ElectroIoT/Restaurant-Calling-Bell/docs/datasheets/module-photo-front.jpg

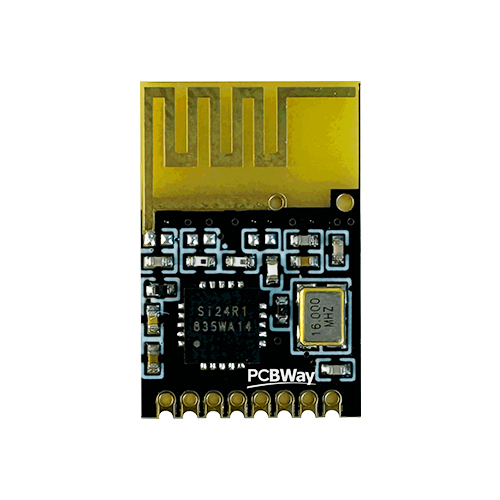
docs/datasheets/module-photo-front.jpg
