ElectroIoT/Restaurant-Calling-Bell/docs/datasheets/module-photo-back.jpg

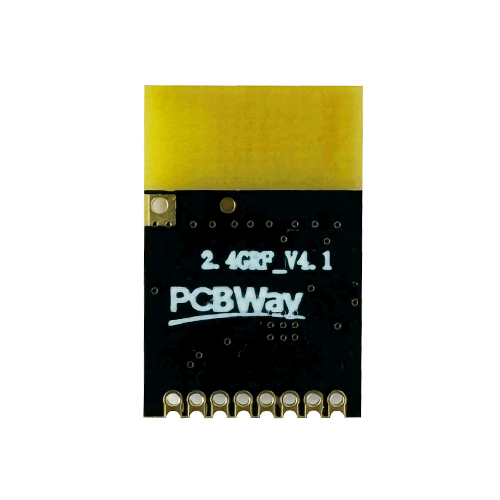
docs/datasheets/module-photo-back.jpg
