ElectroIoT/Restaurant-Calling-Bell/hardware/receiver/kicad/pcb-3d-bottom.png

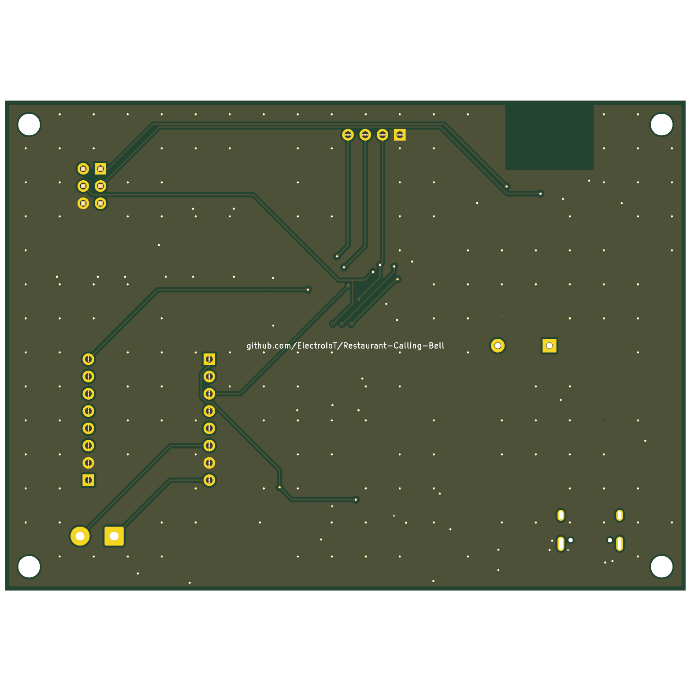
hardware/receiver/kicad/pcb-3d-bottom.png
