ElectroIoT/Restaurant-Calling-Bell/hardware/receiver/kicad/pcb-3d-top.png

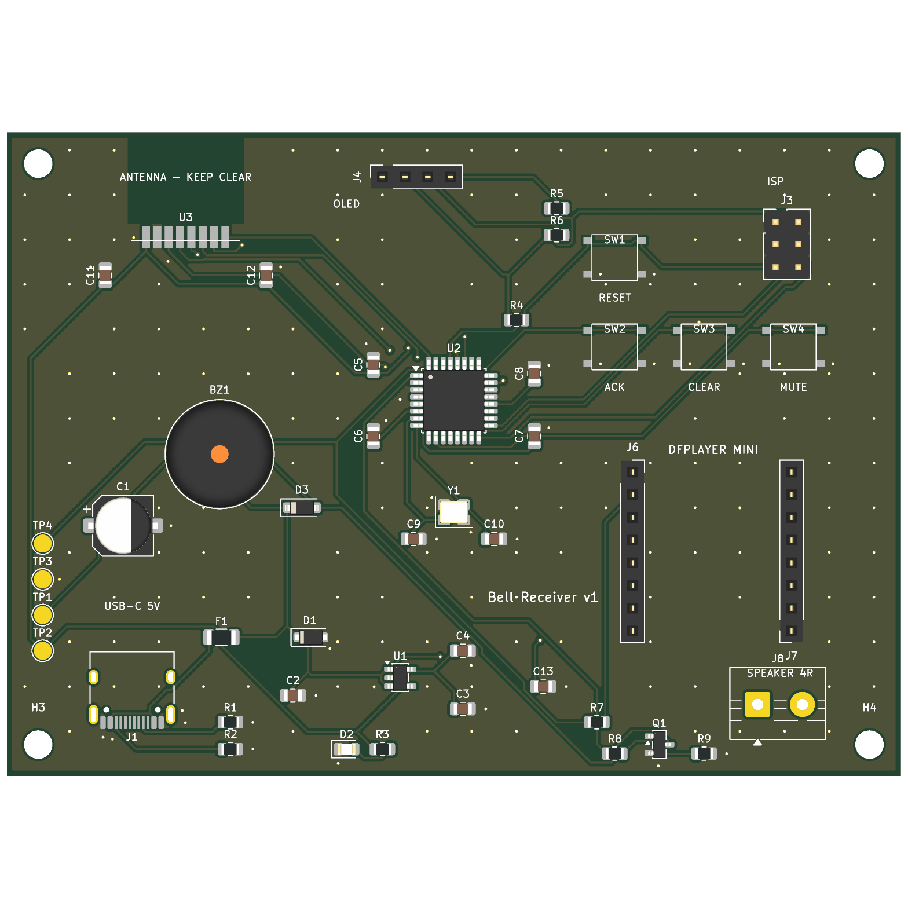
hardware/receiver/kicad/pcb-3d-top.png
