ElectroIoT/Restaurant-Calling-Bell/hardware/remote/kicad/pcb-3d-bottom.png

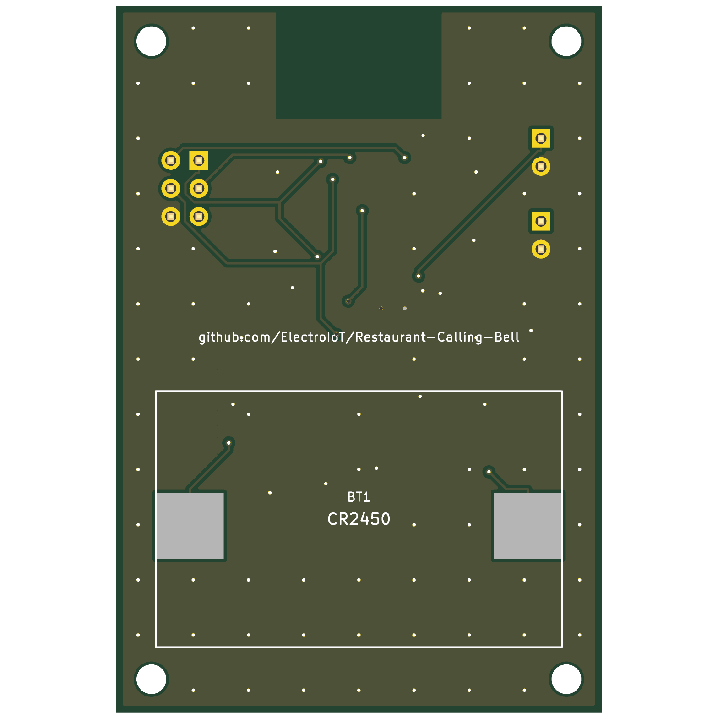
hardware/remote/kicad/pcb-3d-bottom.png
