ElectroIoT/Restaurant-Calling-Bell/hardware/remote/kicad/pcb-3d-top.png

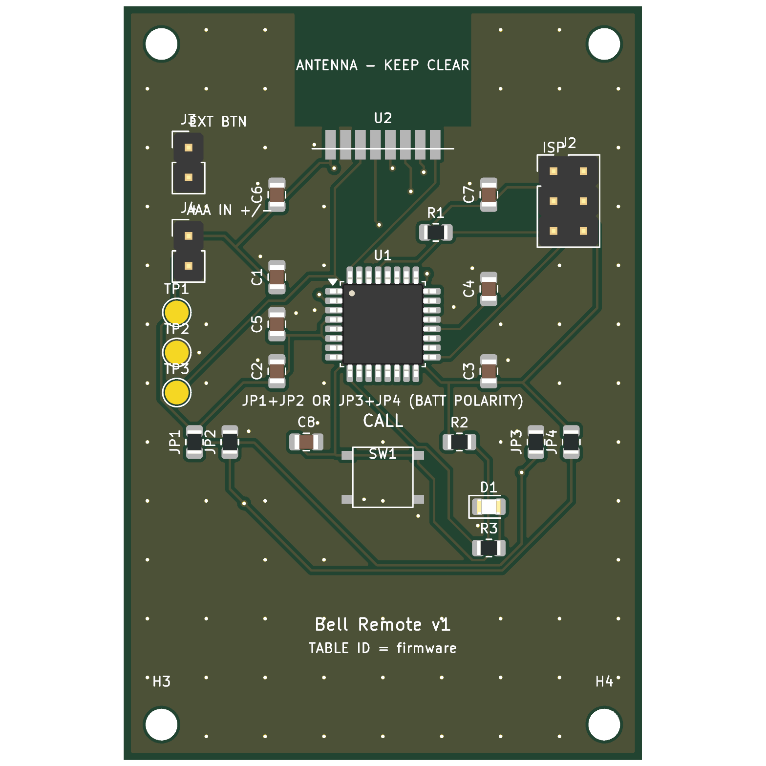
hardware/remote/kicad/pcb-3d-top.png
