ElectroIoT/Restaurant-Calling-Bell/tests/test-results-template.csv

Test # | Test name | Date | Tester | Board set / serial | Firmware git commit | Conditions (battery | distance | channel) | Measured value | Pass criterion | Pass/Fail | Notes
0 | Host protocol tests + firmware builds | 2026-10-29 | Claude (software only) | n/a | see git log | PC | 476 checks 0 failures; 22 builds OK | 0 failures | PASS | Not a hardware result
1 | MCU programming and clock |  |  |  |  |  |  | remote 4 MHz / receiver 8 MHz within 1 %
2 | SPI link |  |  |  |  |  |  | register read-back equals write on all boards
3 | SI24R1 initialisation |  |  |  |  |  |  | RF_SETUP/SETUP_RETR as configured; no RF FAIL
4 | One-way packet |  |  |  |  |  |  | 100/100 at 2 m
5 | Application acknowledgement |  |  |  |  |  |  | solid LED only with receiver up; failure shown <2.5 s
6 | Table id identification |  |  |  |  |  |  | 10/10 correct on OLED and voice
7 | Ten-remote test |  |  |  |  |  |  | 10/10 accepted x10 rounds
8 | Duplicate suppression |  |  |  |  |  |  | one entry per press
9 | Simultaneous calls / collisions |  |  |  |  |  |  | all accepted within 3 s x20
10 | Receiver audio + OLED |  |  |  |  |  |  | reception continues during playback
11 | Debounce / stuck button |  |  |  |  |  |  | one call per press; stuck <10 uA
12 | Battery sag during TX |  |  |  |  |  |  | min voltage >2.2 V; no brown-out
13 | Sleep current |  |  |  |  |  |  | <=5 uA (assumed)
14 | Indoor range |  |  |  |  |  |  | >=19/20 per table
15 | Wi-Fi interference |  |  |  |  |  |  | >=95 % first attempt
16 | Receiver restart / queue recovery |  |  |  |  |  |  | same tables and order restored
17 | 72 h soak |  |  |  |  |  |  | no lost call / reset
18 | Low-battery behaviour |  |  |  |  |  |  | flag from 2.4 V; record cut-off
19 | Regression after firmware change |  |  |  |  |  |  | tests 4-9 and 16 pass
20 | Amplifier thermal |  |  |  |  |  |  | finger-safe; droop <0.3 V
