ElectroIoT/Restaurant-Calling-Bell/hardware/receiver/kicad/BellReceiver-schematic.pdf

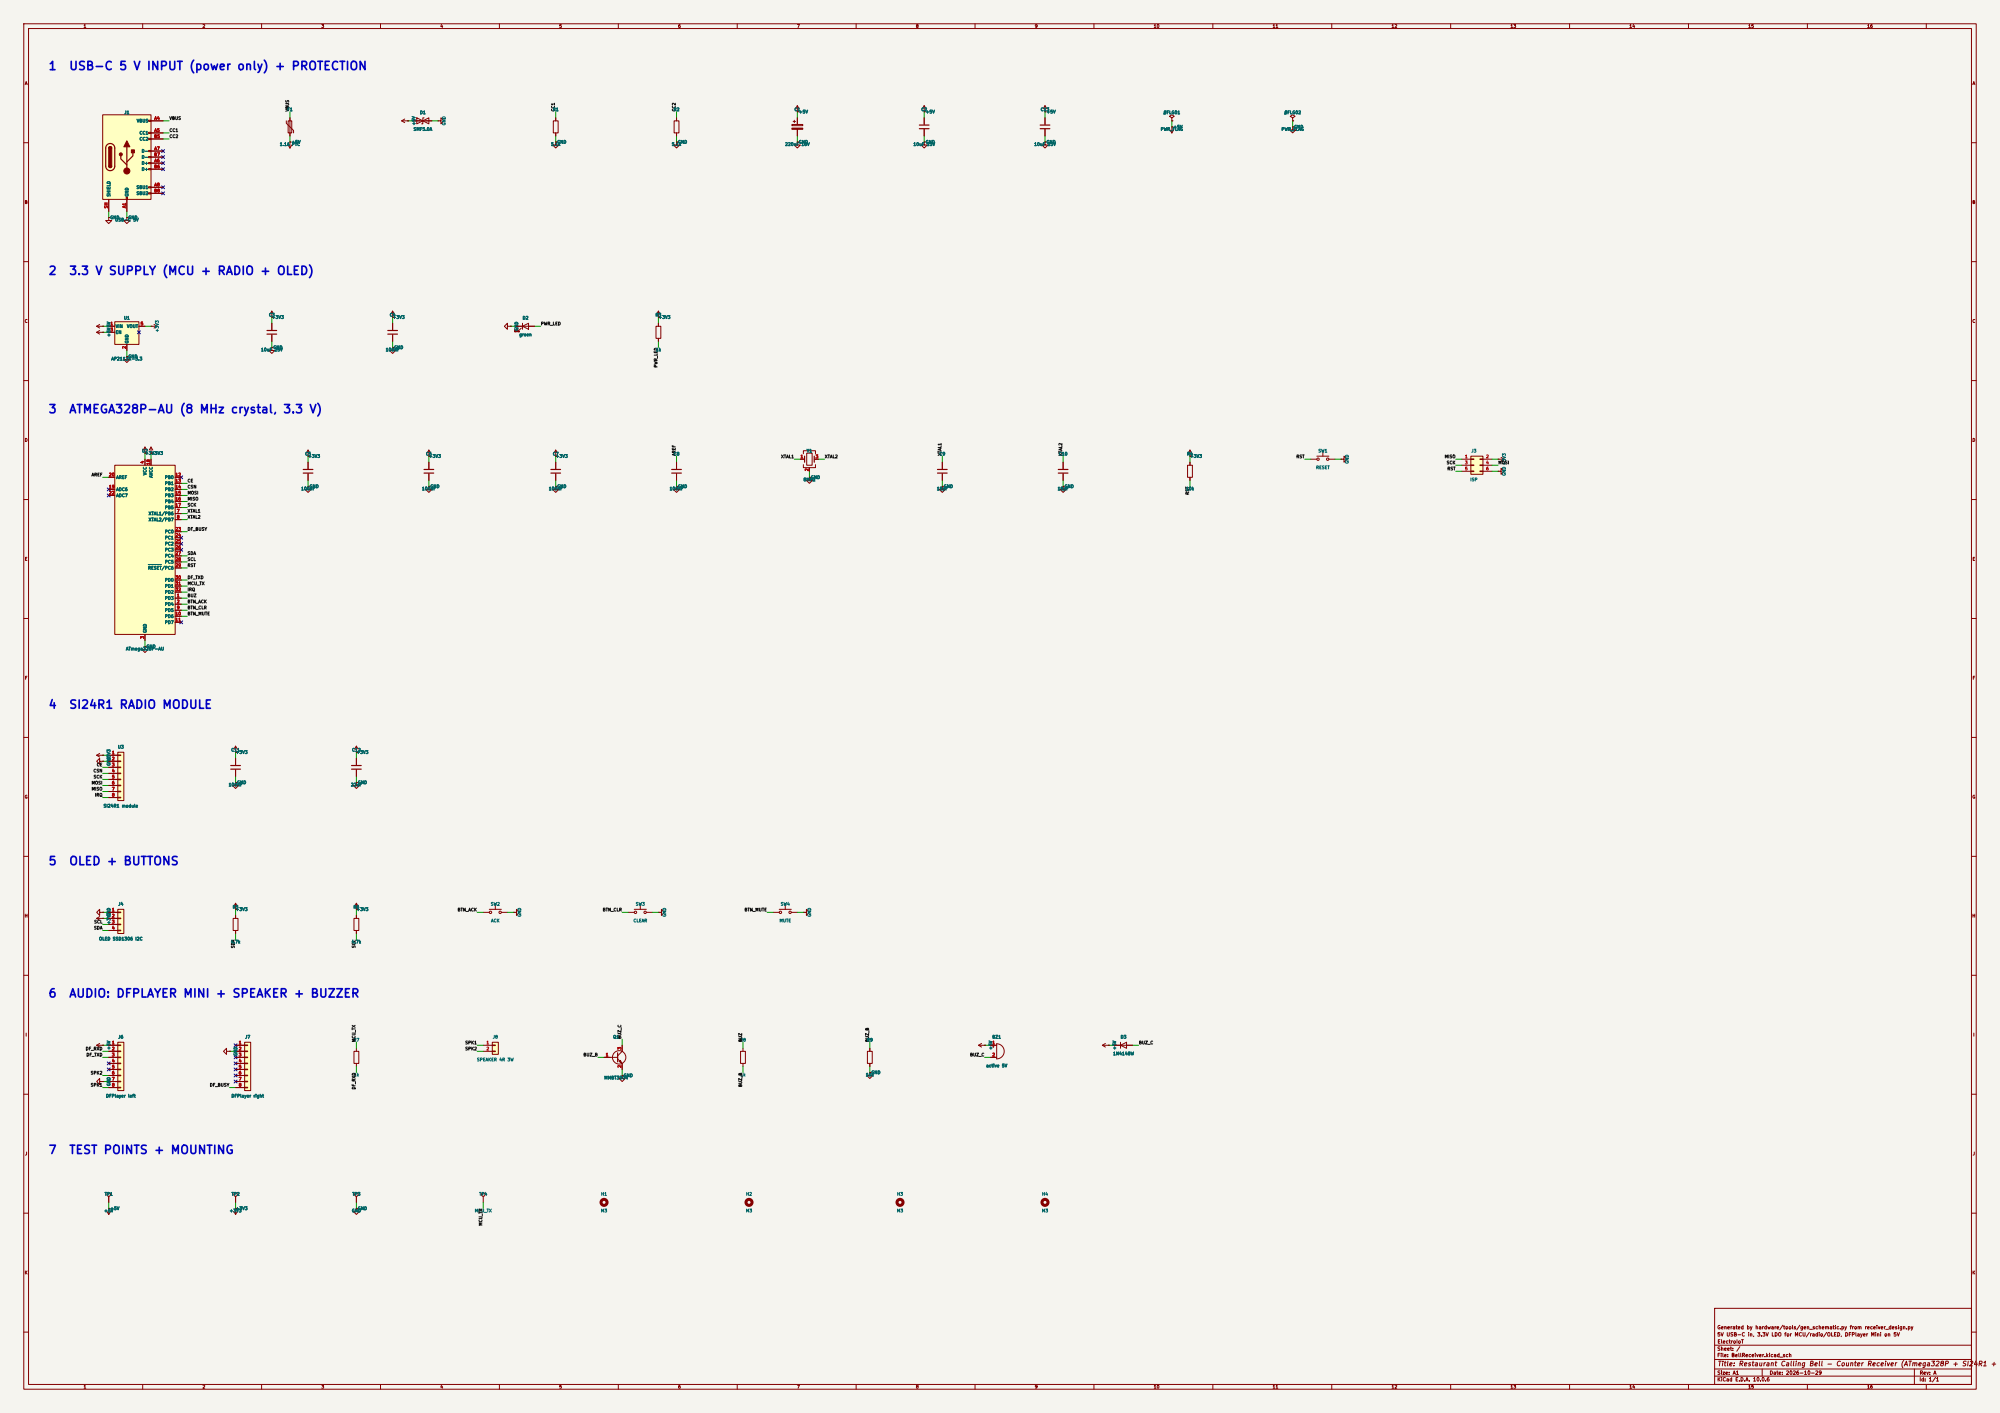
[picture p7: page 1]

1 USB-C 5 V INPUT (power only) + PROTECTION

CE SDA SCL SCK MISO 2 3.3 V SUPPLY (MCU + RADIO + OLED)

Generated by hardware/tools/gen_schematic.py from receiver_design.py
5V USB-C in, 3.3V LDO for MCU/radio/OLED, DFPlayer Mini on 5V
ElectroIoT
Sheet: /
File: BellReceiver.kicad_sch
Title: Restaurant Calling Bell - Counter Receiver (ATmega328P + SI24R1 + OLED + DFPlayer)

Size: A1 | Rev: A
KiCad E.D.A. 10.0.6 | Id: 1/1
