ElectroIoT/Restaurant-Calling-Bell/hardware/remote/kicad/BellRemote-schematic.pdf

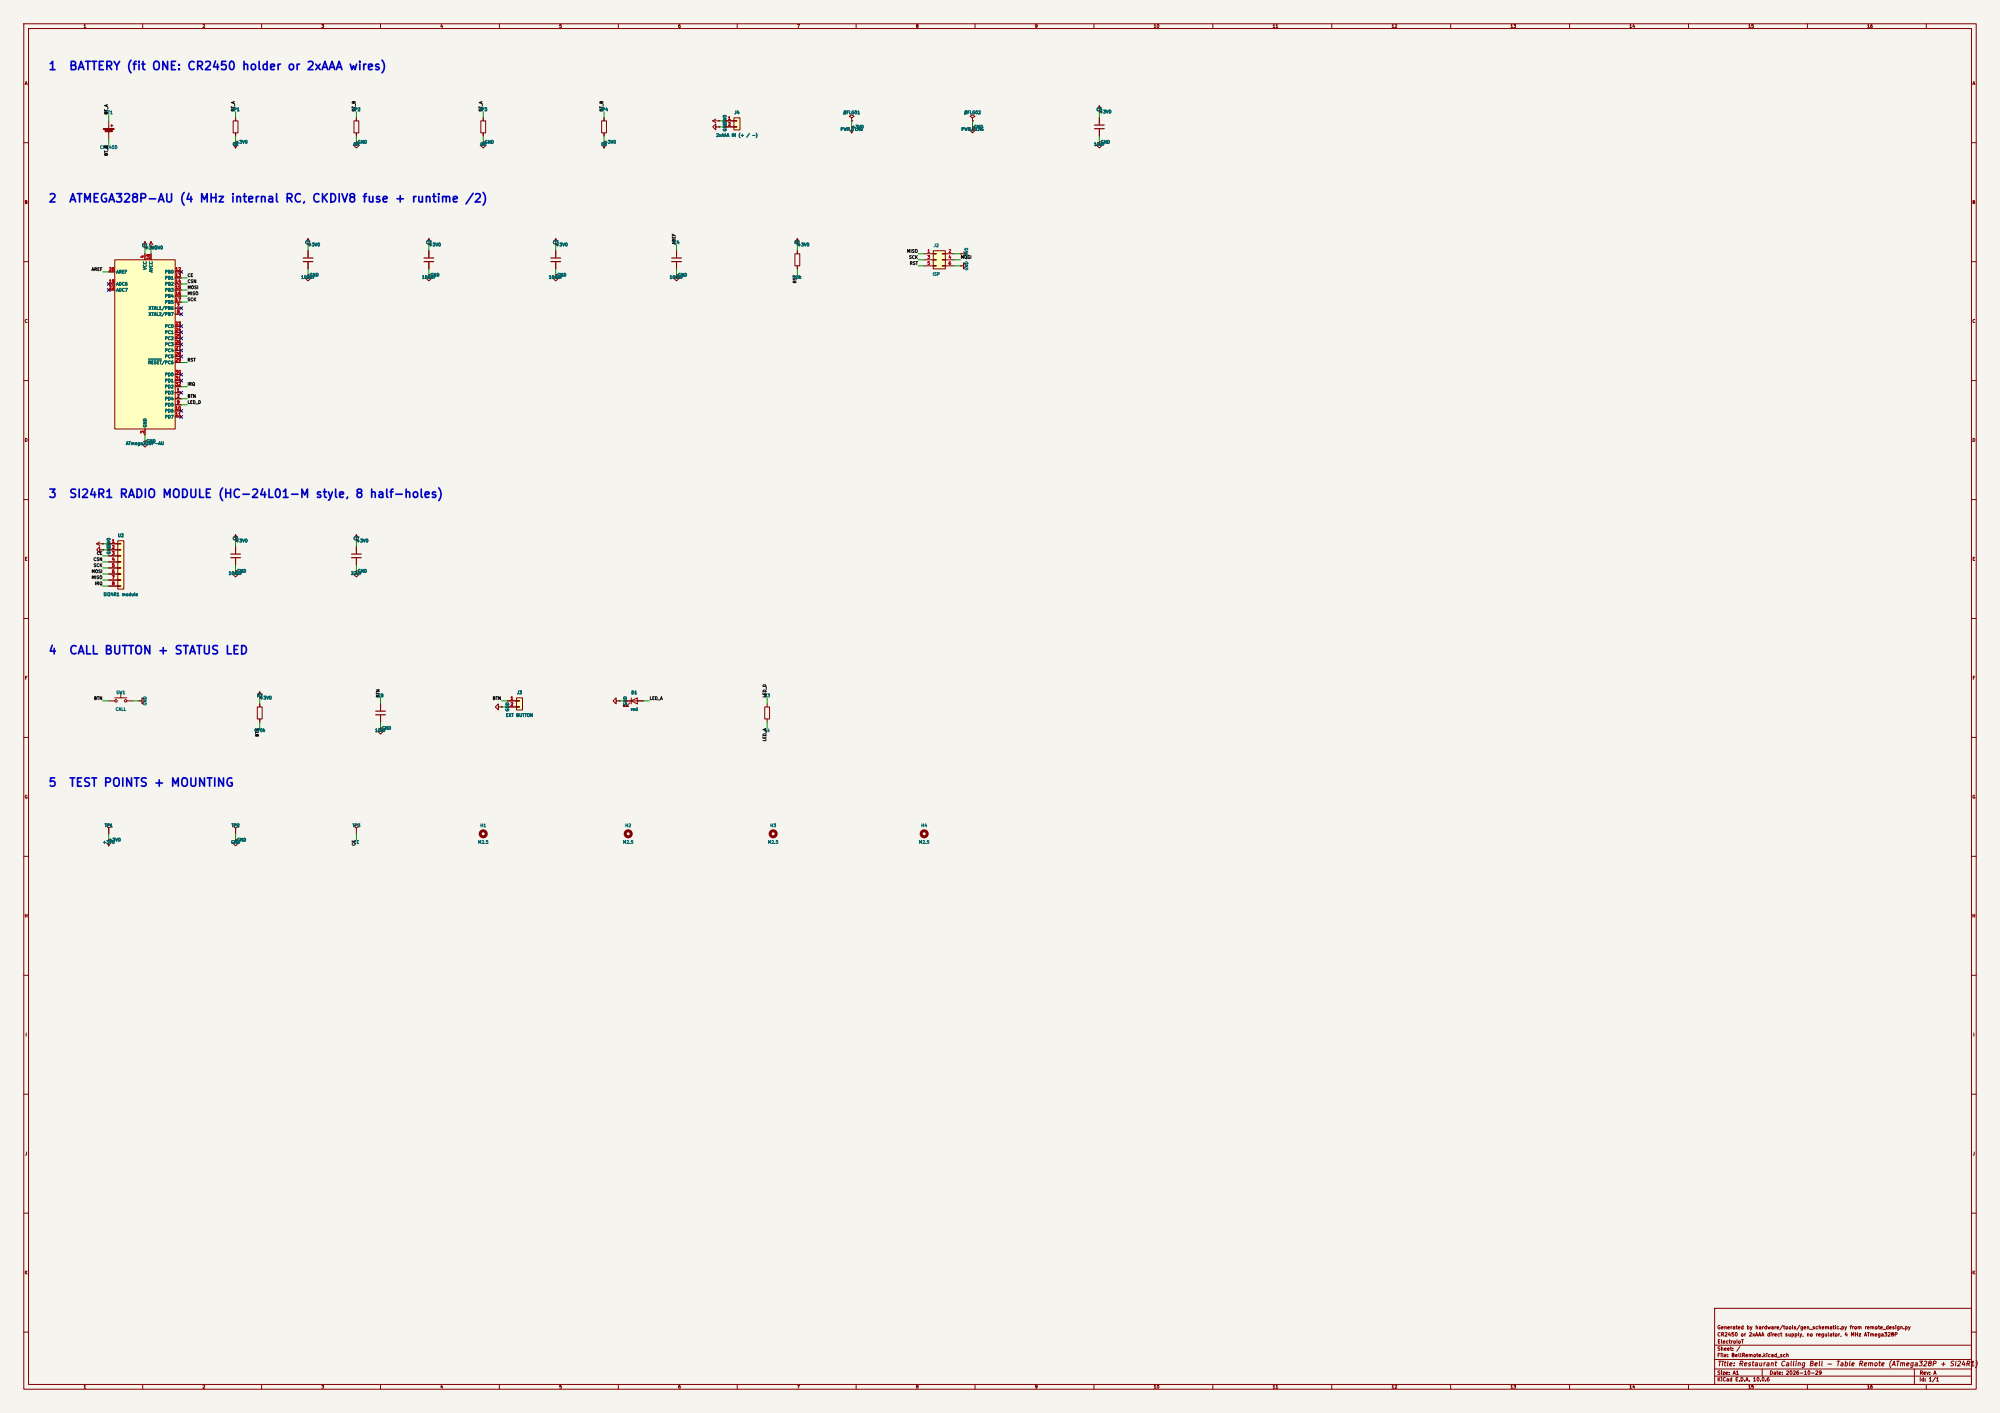
[picture p8: page 1]

CE CSN 1 BATTERY (fit ONE: CR2450 holder or 2xAAA wires)

2 ATMEGA328P-AU (4 MHz internal RC, CKDIV8 fuse + runtime /2)

3 SI24R1 RADIO MODULE (HC-24L01-M style, 8 half-holes)

4 CALL BUTTON + STATUS LED

Generated by hardware/tools/gen_schematic.py from remote_design.py
CR2450 or 2xAAA direct supply, no regulator, 4 MHz ATmega328P
ElectroIoT
Sheet: /
File: BellRemote.kicad_sch
Title: Restaurant Calling Bell - Table Remote (ATmega328P + SI24R1)

Size: A1 | Rev: A
KiCad E.D.A. 10.0.6 | Id: 1/1
