ElectroIoT/Restaurant-Calling-Bell/hardware/receiver/kicad/BellReceiver.kicad_pcb

## KiCad design hardware/receiver/kicad/BellReceiver.kicad_pcb (2026-10-29)

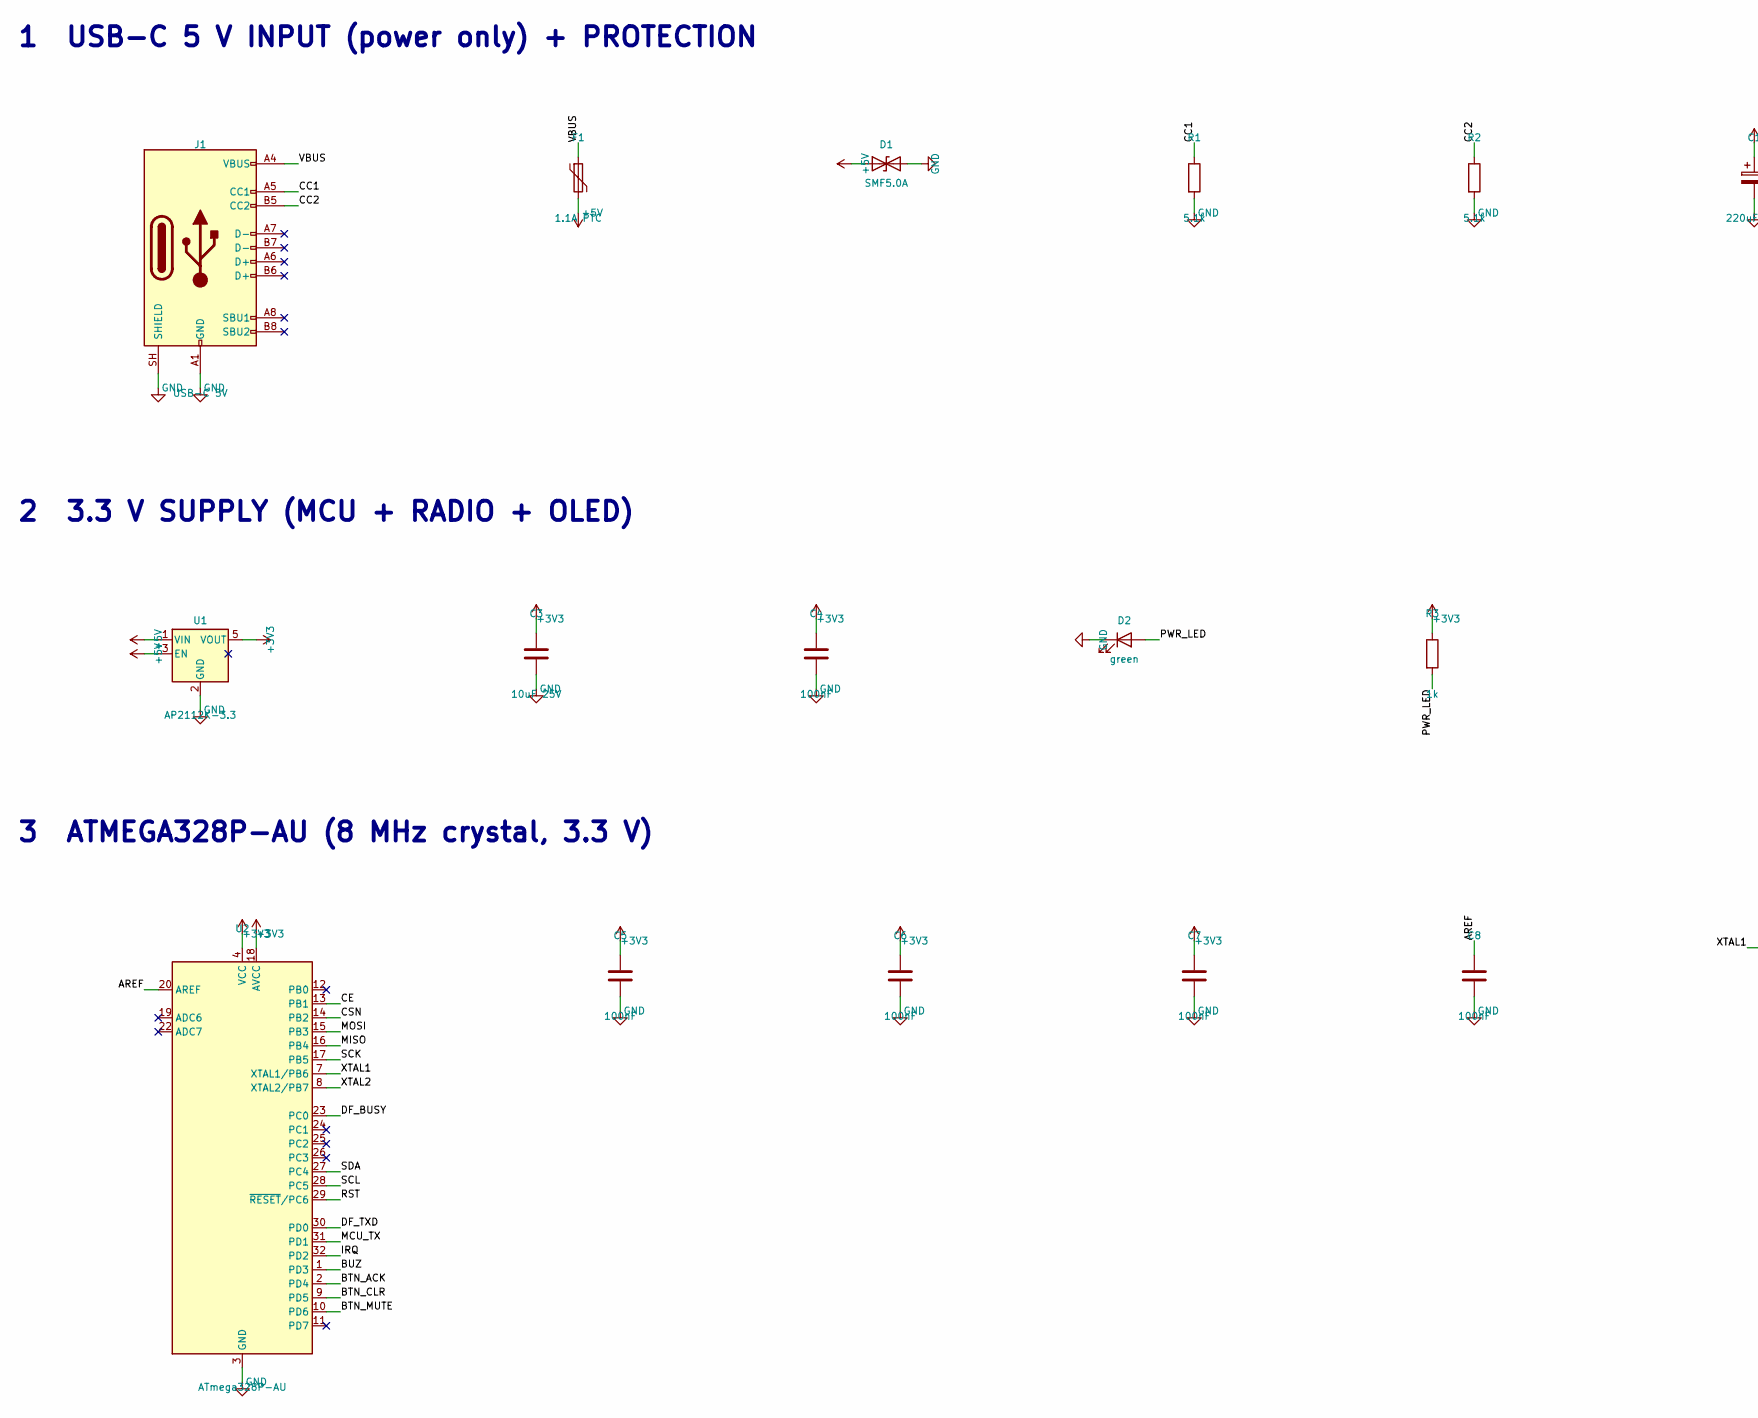
[picture p9: schematic BellReceiver.kicad_sch, Restaurant Calling Bell - Counter Receiver (ATmega328P + SI…, part in row 1, column 1]

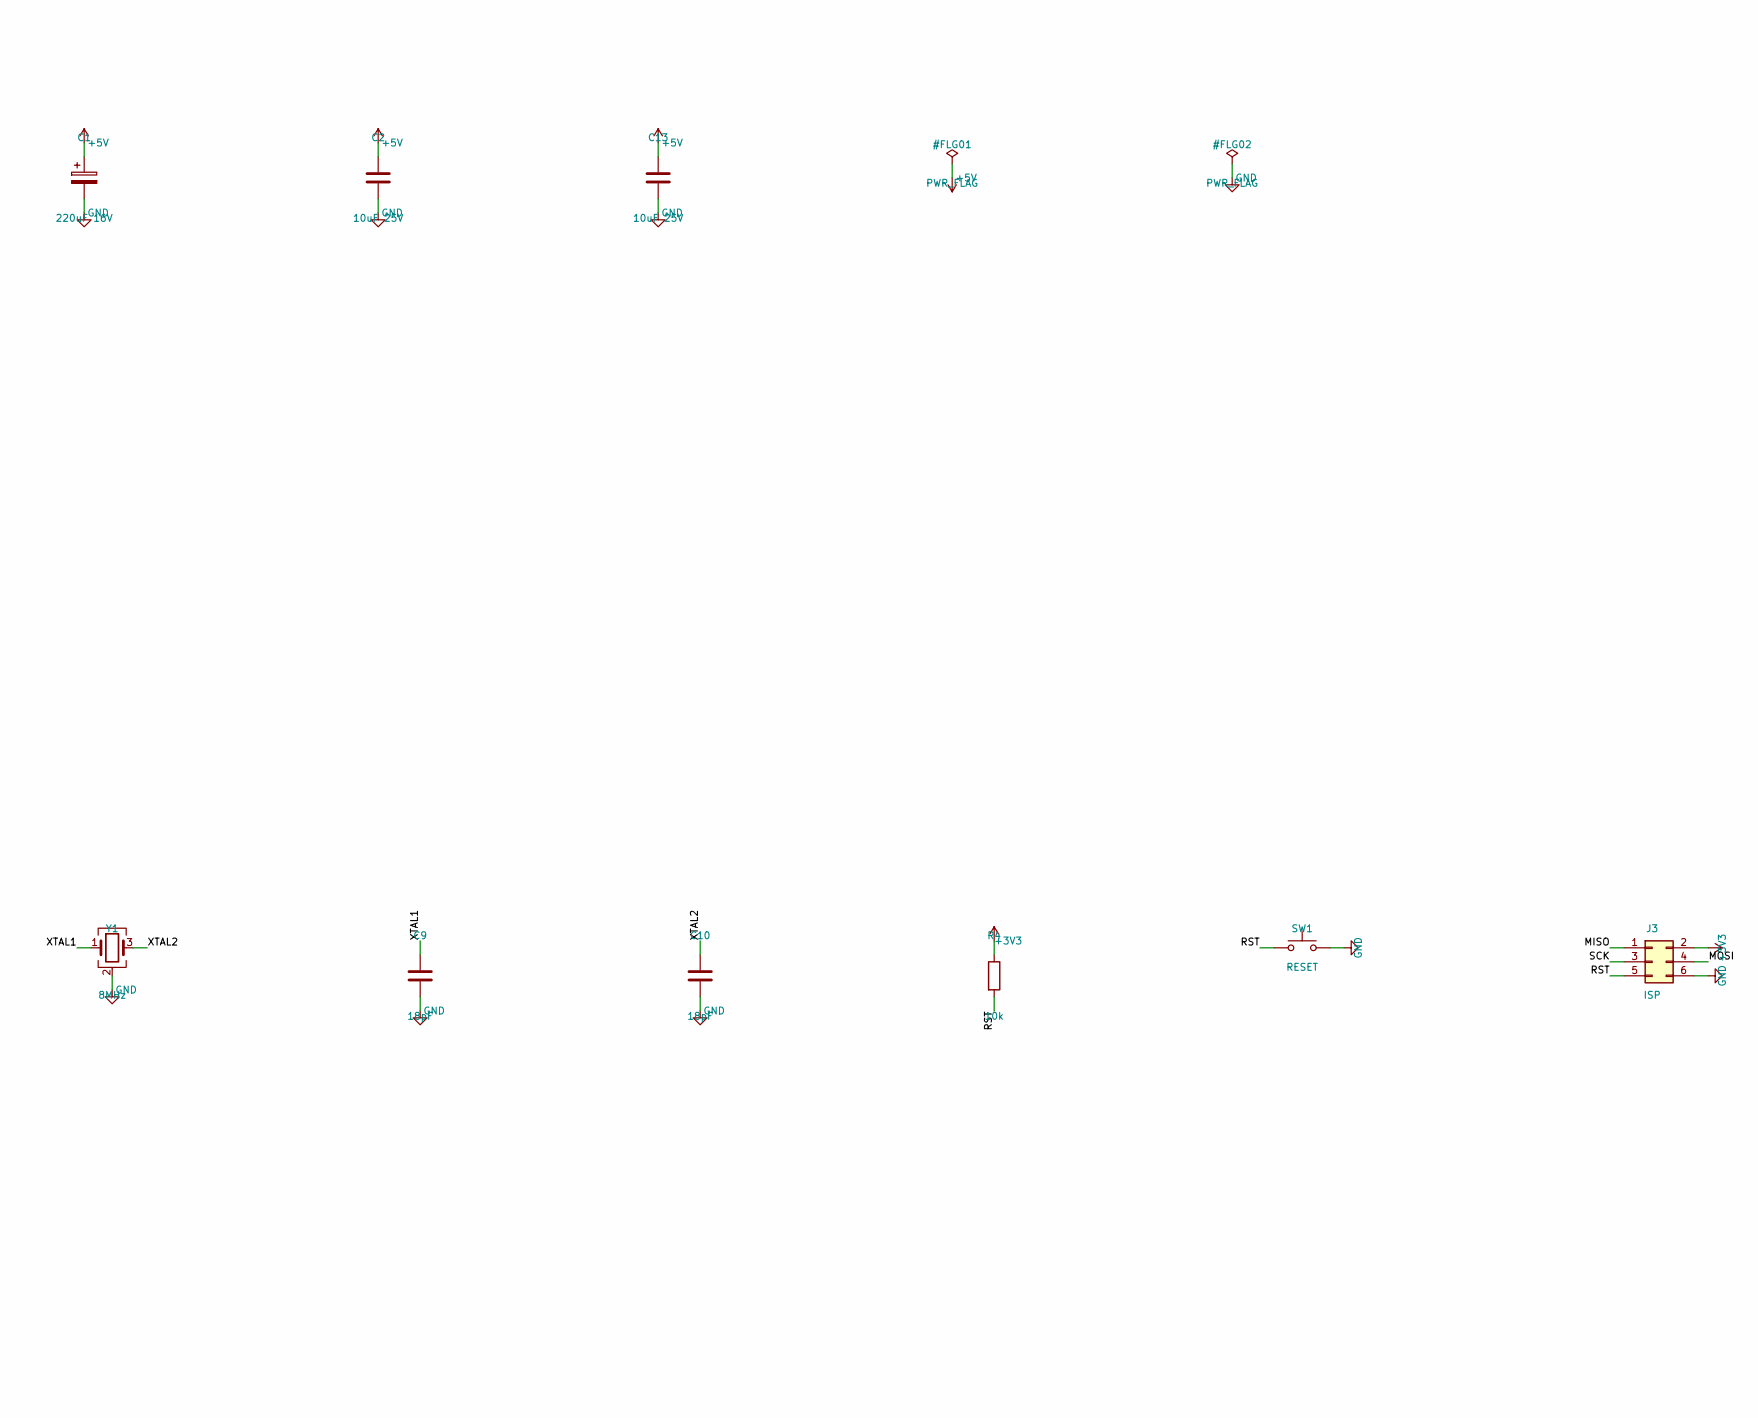
[picture p10: schematic BellReceiver.kicad_sch, Restaurant Calling Bell - Counter Receiver (ATmega328P + SI…, part in row 1, column 2]

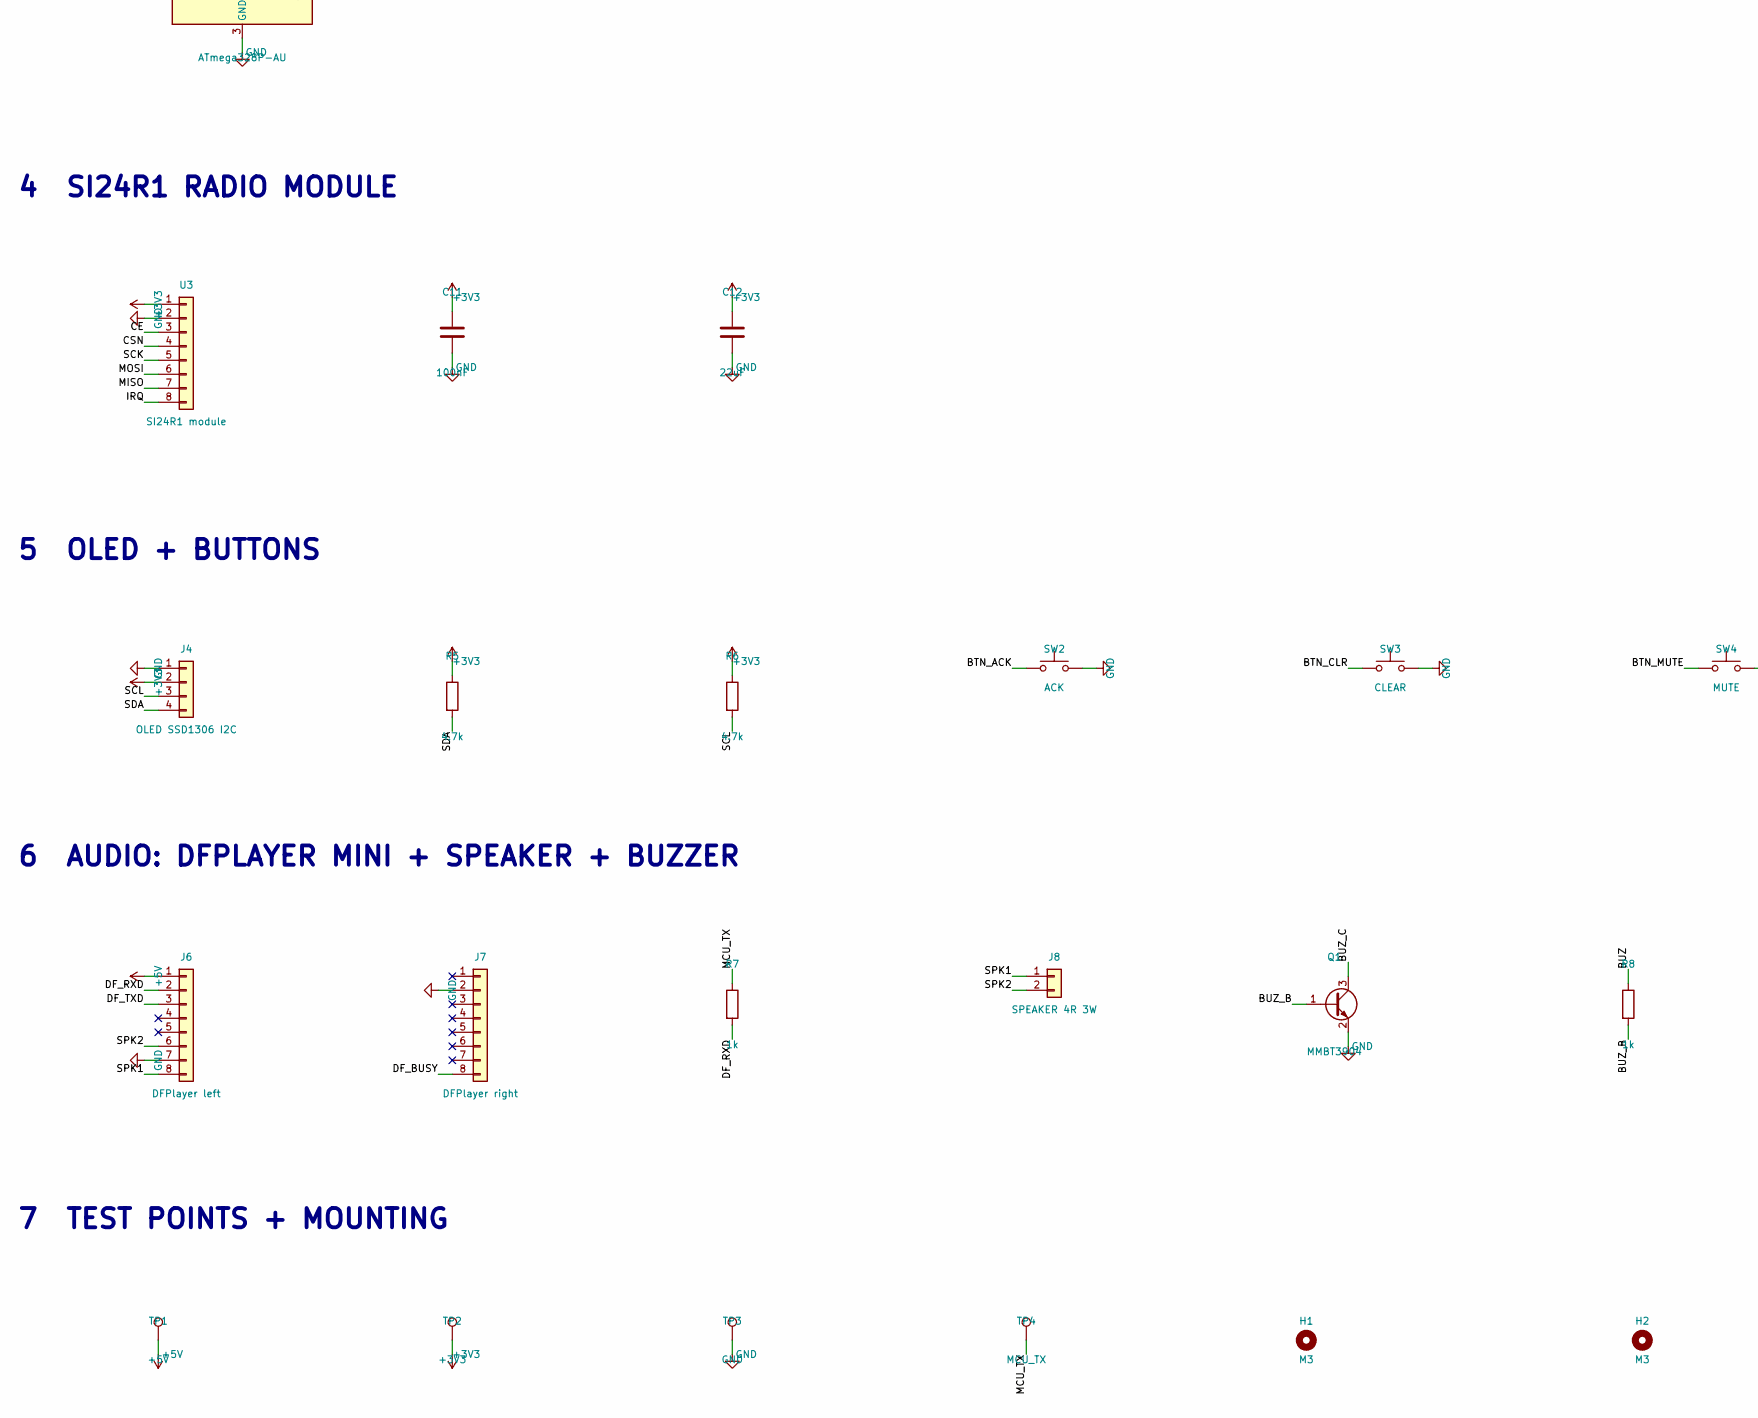
[picture p11: schematic BellReceiver.kicad_sch, Restaurant Calling Bell - Counter Receiver (ATmega328P + SI…, part in row 2, column 1]

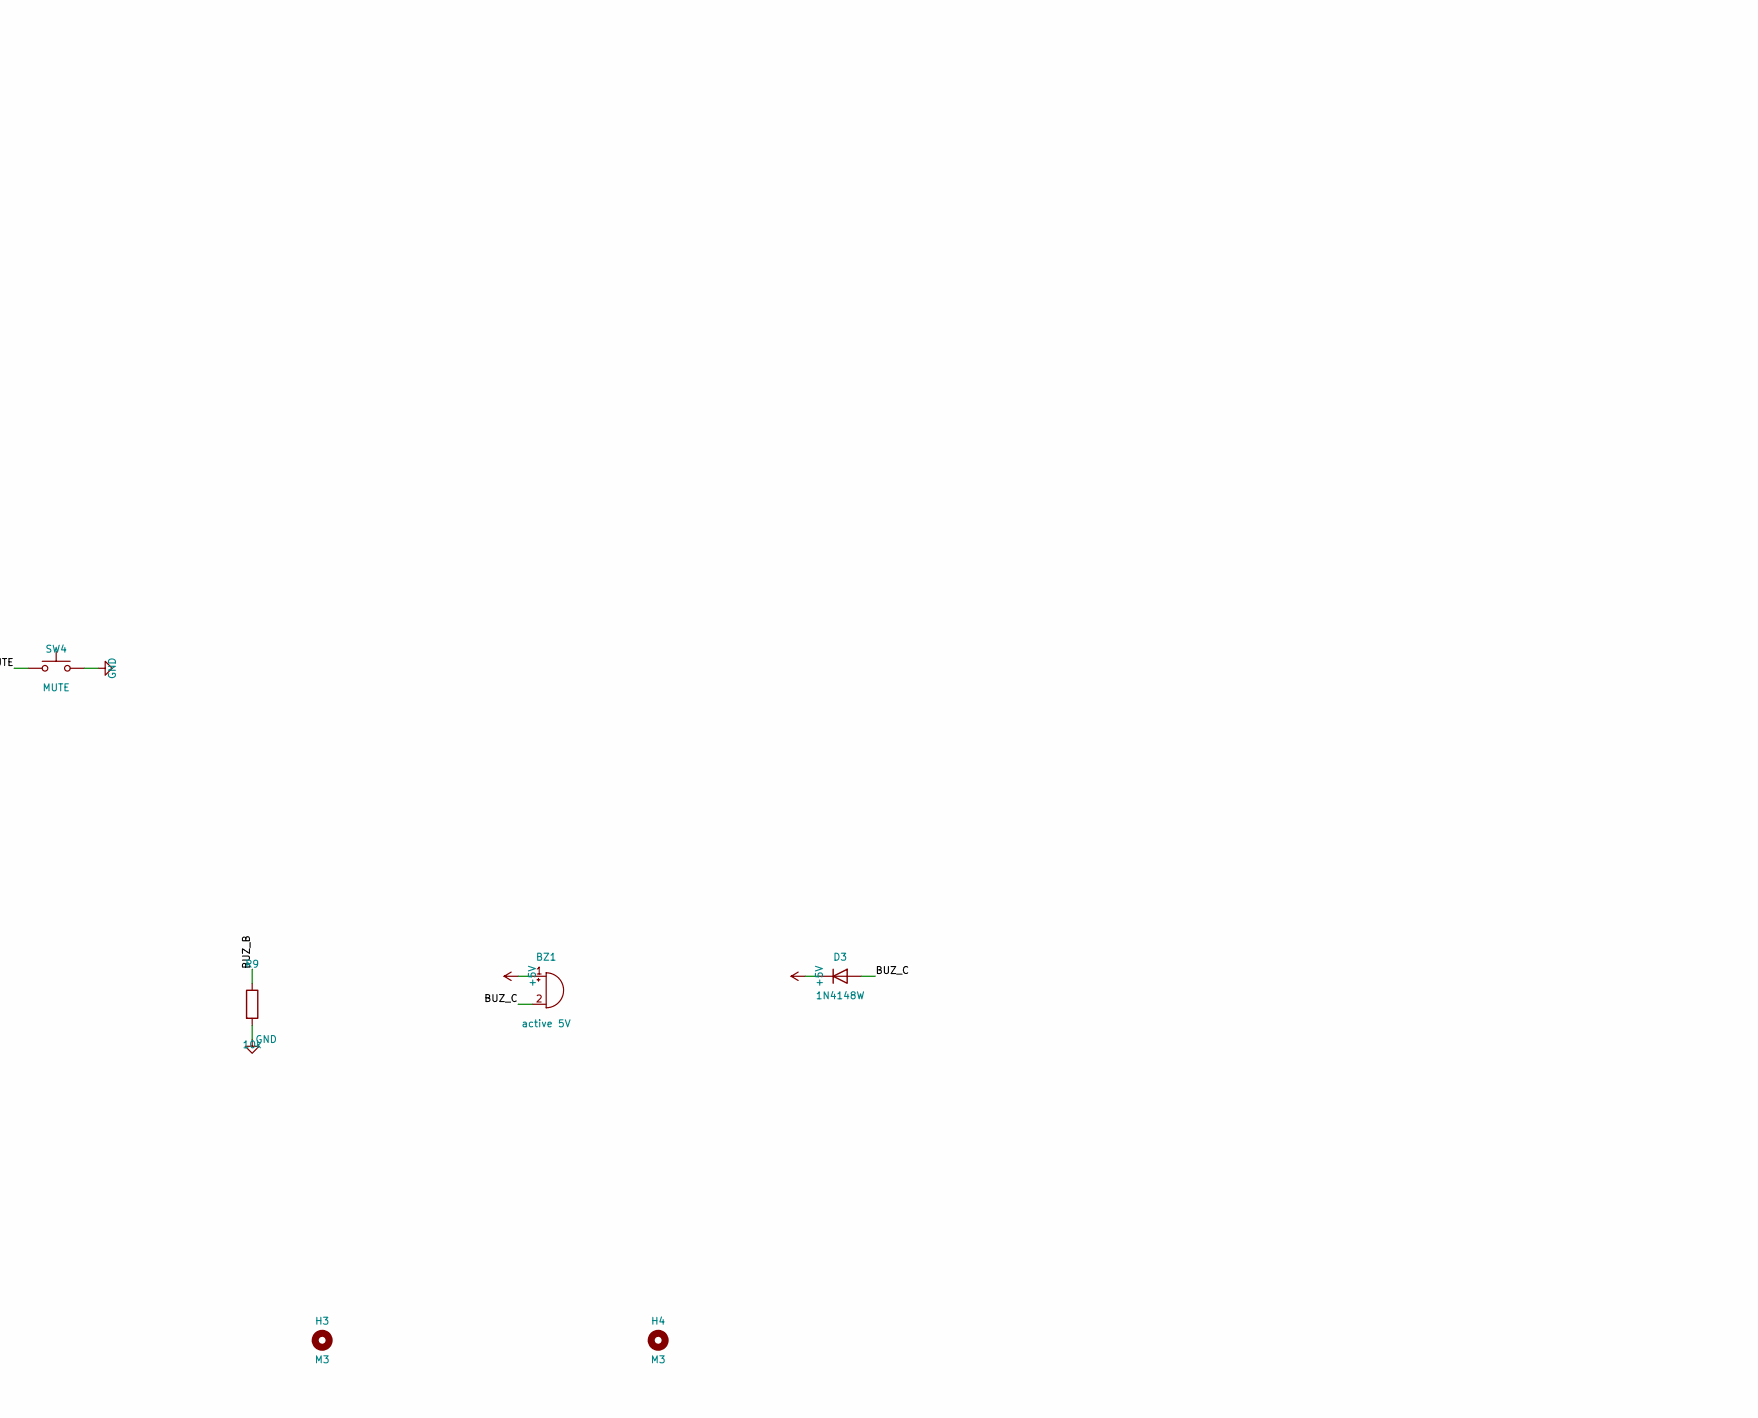
[picture p12: schematic BellReceiver.kicad_sch, Restaurant Calling Bell - Counter Receiver (ATmega328P + SI…, part in row 2, column 2]

Parts:
BZ1: active 5V; Buzzer_12x9.5RM7.6
C1: 220uF 16V; CP_Elec_6.3x7.7
C2, C3, C13: 10uF 25V; C_0805_2012Metric
C4, C5, C6, C7, C8, C11: 100nF; C_0805_2012Metric
C9, C10: 18pF; C_0805_2012Metric
C12: 22uF; C_0805_2012Metric
D1: SMF5.0A; D_SOD-123F
D2: green; LED_0805_2012Metric
D3: 1N4148W; D_SOD-123
F1: 1.1A PTC; Fuse_1206_3216Metric
H1, H2, H3, H4: M3; MountingHole_3.2mm_M3
J1: USB-C 5V; USB_C_Receptacle_HRO_TYPE-C-31-M-12
J3: ISP; PinHeader_2x03_P2.54mm_Vertical
J4: OLED SSD1306 I2C; PinSocket_1x04_P2.54mm_Vertical
J6: DFPlayer left; PinSocket_1x08_P2.54mm_Vertical
J7: DFPlayer right; PinSocket_1x08_P2.54mm_Vertical
J8: SPEAKER 4R 3W; TerminalBlock_MaiXu_MX126-5.0-02P_1x02_P5.00mm
Q1: MMBT3904; SOT-23
R1, R2: 5.1k; R_0805_2012Metric
R3, R7, R8: 1k; R_0805_2012Metric
R4, R9: 10k; R_0805_2012Metric
R5, R6: 4.7k; R_0805_2012Metric
SW1: RESET; SW_TS-1187A
SW2: ACK; SW_TS-1187A
SW3: CLEAR; SW_TS-1187A
SW4: MUTE; SW_TS-1187A
TP1: +5V; TestPoint_Pad_D2.0mm
TP2: +3V3; TestPoint_Pad_D2.0mm
TP3: GND; TestPoint_Pad_D2.0mm
TP4: MCU_TX; TestPoint_Pad_D2.0mm
U1: AP2112K-3.3; SOT-23-5
U2: ATmega328P-AU; TQFP-32_7x7mm_P0.8mm
U3: SI24R1 module; SI24R1_Module_12x18
Y1: 8MHz; Crystal_SMD_3225-4Pin_3.2x2.5mm

Connections:
+3V3: C3.1, C4.1, C5.1, C6.1, C7.1, C11.1, C12.1, J3.2, J4.2, R3.1, R4.1, R5.1, R6.1, TP2.1, U1.5 (VOUT), U2.4 (VCC), U2.6 (VCC), U2.18 (AVCC), U3.1
+5V: BZ1.1 (+), C1.1, C2.1, C13.1, D1.1 (A1), D3.1 (K), F1.2, J6.1, TP1.1, U1.1 (VIN), U1.3 (EN)
AREF: C8.1, U2.20 (AREF)
BTN_ACK: SW2.1, U2.2 (PD4)
BTN_CLR: SW3.1, U2.9 (PD5)
BTN_MUTE: SW4.1, U2.10 (PD6)
BUZ: R8.1, U2.1 (PD3)
BUZ_B: Q1.1 (B), R8.2, R9.1
BUZ_C: BZ1.2 (-), D3.2 (A), Q1.3 (C)
CC1: J1.A5 (CC1), R1.1
CC2: J1.B5 (CC2), R2.1
CE: U2.13 (PB1), U3.3
CSN: U2.14 (PB2), U3.4
DF_BUSY: J7.8, U2.23 (PC0)
DF_RXD: J6.2, R7.2
DF_TXD: J6.3, U2.30 (PD0)
GND: C1.2, C2.2, C3.2, C4.2, C5.2, C6.2, C7.2, C8.2, C9.2, C10.2, C11.2, C12.2, C13.2, D1.2 (A2), D2.1 (K), J1.A1 (GND), J1.A12 (GND), J1.B1 (GND), J1.B12 (GND), J1.SH (SHIELD), J3.6, J4.1, J6.7, J7.2, Q1.2 (E), R1.2, R2.2, R9.2, SW1.2, SW2.2, SW3.2, SW4.2, TP3.1, U1.2 (GND), U2.3 (GND), U2.5 (GND), U2.21 (GND), U3.2, Y1.2 (G), Y1.4 (G)
IRQ: U2.32 (PD2), U3.8
MCU_TX: R7.1, TP4.1, U2.31 (PD1)
MISO: J3.1, U2.16 (PB4), U3.7
MOSI: J3.4, U2.15 (PB3), U3.6
PWR_LED: D2.2 (A), R3.2
RST: J3.5, R4.2, SW1.1, U2.29 (~RESET/PC6)
SCK: J3.3, U2.17 (PB5), U3.5
SCL: J4.3, R6.2, U2.28 (PC5)
SDA: J4.4, R5.2, U2.27 (PC4)
SPK1: J6.8, J8.1
SPK2: J6.6, J8.2
VBUS: F1.1, J1.A4 (VBUS), J1.A9 (VBUS), J1.B4 (VBUS), J1.B9 (VBUS)
XTAL1: C9.1, U2.7 (XTAL1/PB6), Y1.1
XTAL2: C10.1, U2.8 (XTAL2/PB7), Y1.3

Notes on the sheet:
1 USB-C 5 V INPUT (power only) + PROTECTION
2 3.3 V SUPPLY (MCU + RADIO + OLED)
3 ATMEGA328P-AU (8 MHz crystal, 3.3 V)
4 SI24R1 RADIO MODULE
5 OLED + BUTTONS
6 AUDIO: DFPLAYER MINI + SPEAKER + BUZZER
7 TEST POINTS + MOUNTING

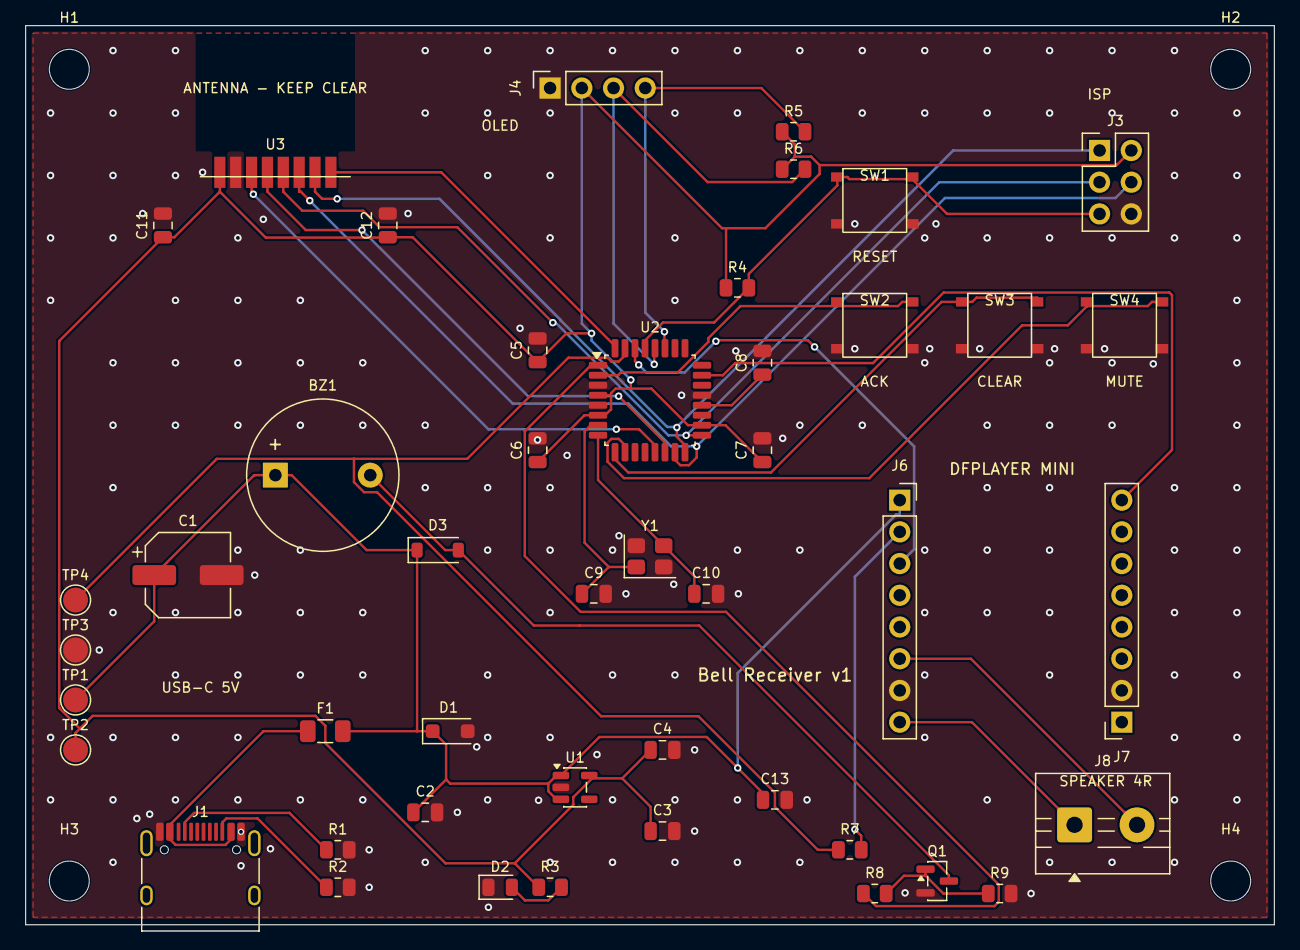
[picture p13: board BellReceiver.kicad_pcb from above]

Board: 2 copper layers, 100.0 x 72.0 mm, 50 parts (0 on the bottom side), 31 nets.
