ElectroIoT/Restaurant-Calling-Bell/hardware/remote/kicad/BellRemote.kicad_pcb

## KiCad design hardware/remote/kicad/BellRemote.kicad_pcb (2026-10-29)

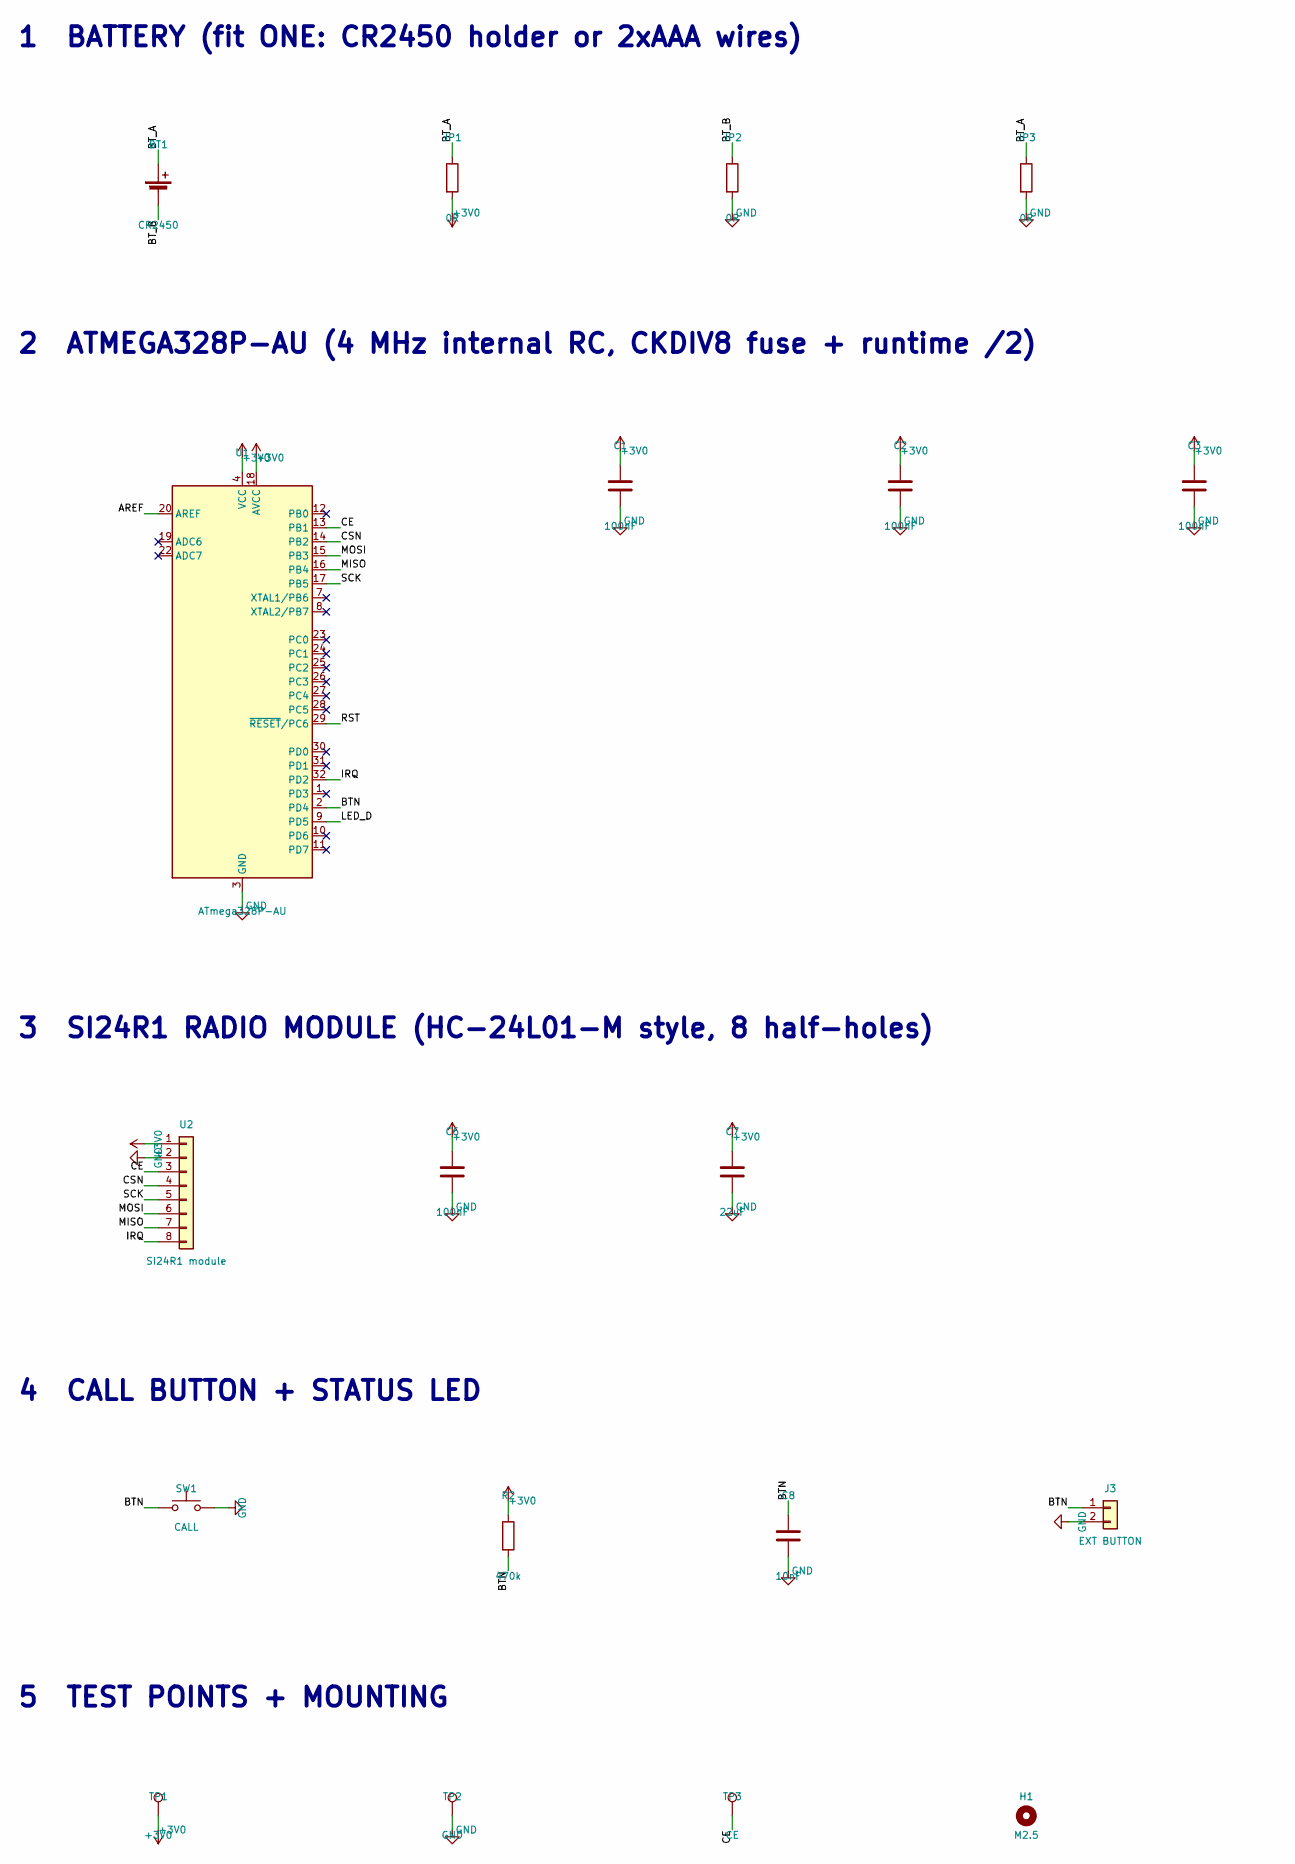
[picture p14: schematic BellRemote.kicad_sch, Restaurant Calling Bell - Table Remote (ATmega328P + SI24R1), part in row 1, column 1]

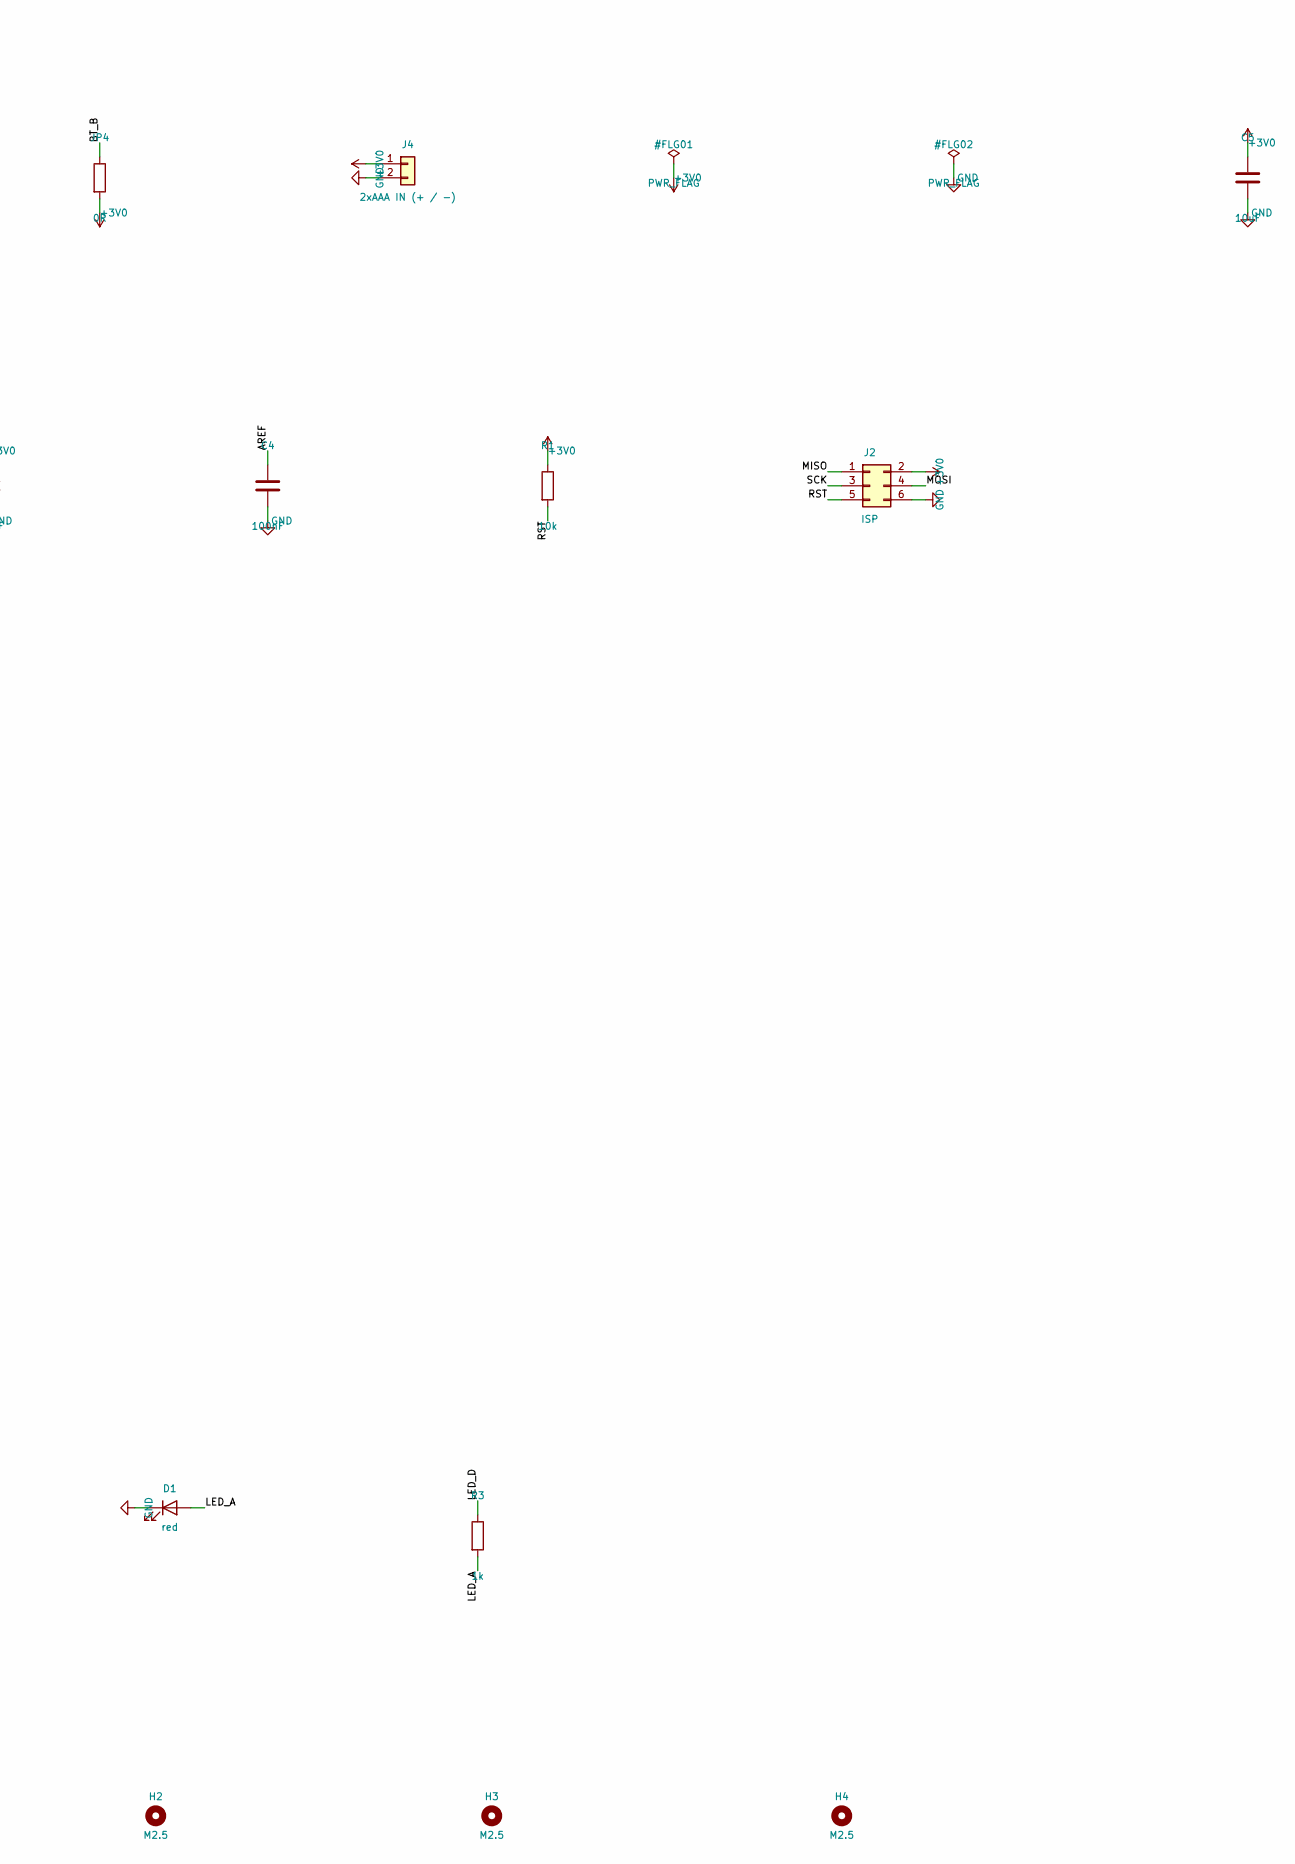
[picture p15: schematic BellRemote.kicad_sch, Restaurant Calling Bell - Table Remote (ATmega328P + SI24R1), part in row 1, column 2]

Parts:
BT1: CR2450; CR2450_Holder_MY-2450-01
C1, C2, C3, C4, C6: 100nF; C_0805_2012Metric
C5: 10uF; C_0805_2012Metric
C7: 22uF; C_0805_2012Metric
C8: 10nF; C_0805_2012Metric
D1: red; LED_0805_2012Metric
H1, H2, H3, H4: M2.5; MountingHole_2.7mm_M2.5
J2: ISP; PinHeader_2x03_P2.54mm_Vertical
J3: EXT BUTTON; PinHeader_1x02_P2.54mm_Vertical
J4: 2xAAA IN (+ / -); PinHeader_1x02_P2.54mm_Vertical
JP1, JP2, JP3, JP4: 0R; R_0805_2012Metric
R1: 10k; R_0805_2012Metric
R2: 470k; R_0805_2012Metric
R3: 1k; R_0805_2012Metric
SW1: CALL; SW_TS-1187A
TP1: +3V0; TestPoint_Pad_D2.0mm
TP2: GND; TestPoint_Pad_D2.0mm
TP3: CE; TestPoint_Pad_D2.0mm
U1: ATmega328P-AU; TQFP-32_7x7mm_P0.8mm
U2: SI24R1 module; SI24R1_Module_12x18

Connections:
+3V0: C1.1, C2.1, C3.1, C5.1, C6.1, C7.1, J2.2, J4.1, JP1.2, JP4.2, R1.1, R2.1, TP1.1, U1.4 (VCC), U1.6 (VCC), U1.18 (AVCC), U2.1
AREF: C4.1, U1.20 (AREF)
BTN: C8.1, J3.1, R2.2, SW1.1, U1.2 (PD4)
BT_A: BT1.1 (+), JP1.1, JP3.1
BT_B: BT1.2 (-), JP2.1, JP4.1
CE: TP3.1, U1.13 (PB1), U2.3
CSN: U1.14 (PB2), U2.4
GND: C1.2, C2.2, C3.2, C4.2, C5.2, C6.2, C7.2, C8.2, D1.1 (K), J2.6, J3.2, J4.2, JP2.2, JP3.2, SW1.2, TP2.1, U1.3 (GND), U1.5 (GND), U1.21 (GND), U2.2
IRQ: U1.32 (PD2), U2.8
LED_A: D1.2 (A), R3.2
LED_D: R3.1, U1.9 (PD5)
MISO: J2.1, U1.16 (PB4), U2.7
MOSI: J2.4, U1.15 (PB3), U2.6
RST: J2.5, R1.2, U1.29 (~RESET/PC6)
SCK: J2.3, U1.17 (PB5), U2.5

Notes on the sheet:
1 BATTERY (fit ONE: CR2450 holder or 2xAAA wires)
2 ATMEGA328P-AU (4 MHz internal RC, CKDIV8 fuse + runtime /2)
3 SI24R1 RADIO MODULE (HC-24L01-M style, 8 half-holes)
4 CALL BUTTON + STATUS LED
5 TEST POINTS + MOUNTING

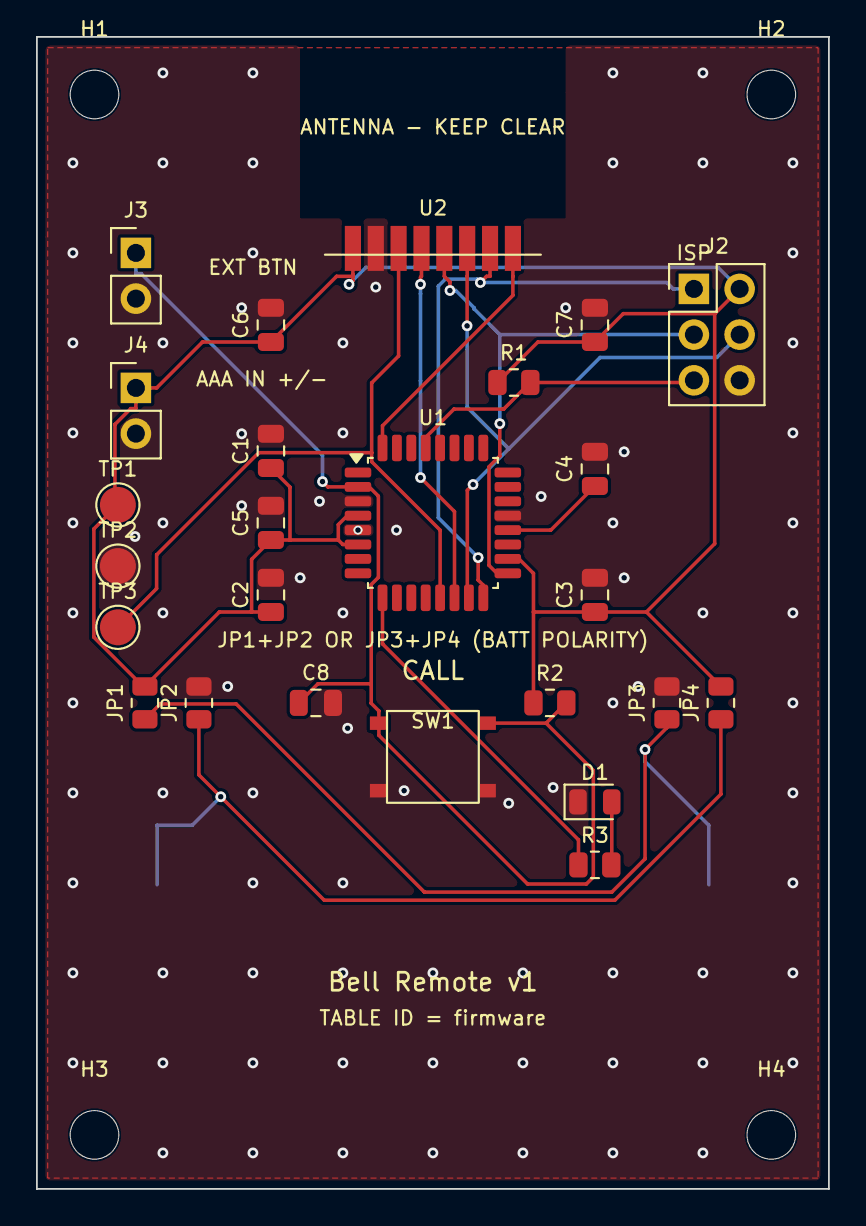
[picture p16: board BellRemote.kicad_pcb from above]

Board: 2 copper layers, 44.0 x 64.0 mm, 30 parts (1 on the bottom side), 15 nets.
