ElectroIoT/Restaurant-Calling-Bell/(commit log)

2026-10-29 Common protocol/call table/persistence/radio driver and remote firmware (compiles for Uno + 4MHz PCB)
2026-10-29 Docs, plan page, BOMs with LCSC data, EasyEDA data pack, KiCad reference boards, test plan, sleep during LED/lockout
    [BellReceiver.kicad_pcb, BellReceiver.kicad_sch, BellRemote.kicad_pcb, BellRemote.kicad_sch, bom-easyeda.csv, netlist.csv, nets-by-pin.csv, placement-hint.csv]
2026-10-29 BOM: record Robocraze DFPlayer Mini listing (size, supply, unlabeled pins)
    [receiver-1x.csv, system-complete.csv]
